harold65/SolarMeter/README.md

# SolarMeter
Documentation is stored in the 'docs' folder.

* Documentation on how to install the hardware is found in the (docs/hardwaremanual.pdf) file
* The software manual is found in docs/softwaremanual.pdf.
* An extra manual on setting up the libraries for this project can be found in [updating libraries](docs/Updating libraries for Solarmeter.pdf)
