harold65/SolarMeter/(threads)

Thread 1 (2017-04-29):

Temperature not logged correctly

harold65, 2017-04-29:
When using buienradar as source for temperature, the value is not correctly read.

FunnyAnimal, 2017-09-22:
I think this is related to the issue i just submitted, https://github.com/harold65/SolarMeter/issues/3 .

harold65, 2017-10-12:
The issue is not the value itself but the fact that the arduino is too slow to scan the >50K xml data returned from xml.buienradar.nl
Older Arduino versions have a faster (but less reliable) Find() function that will work ok.

FunnyAnimal, 2017-10-13:
What exactly do you mean with "Older Arduino versions" ? Older IDE?

I am using IDE version 1.8.3 and it works fine. (My Arduino UNO board is from May 2013.)

I use the following code in Temperature.cpp, it has been working fine now for over a year:

```
void Temperature::GetTemperature()
{
    // Get temperature from buienradar
    EthernetClient buienradarClient;

    int res = 0;
    int retries = 5;
    while (retries-- > 0 && res != 1)
    {
      res = buienradarClient.connect((char*)"xml.buienradar.nl",80);
      if (retries > 0 && res != 1) delay(561);  // Arbitrary delay
    }
    if(res == 1) // connection successfull
    {
        buienradarClient << F("GET / HTTP/1.1") << endl;
        buienradarClient << F("Host: xml.buienradar.nl") << endl << endl;

        retries = 50; // Wait maximally 50 * 0.05 = 2.5 seconds
        while(retries-- > 0
            && buienradarClient.connected()
            && ! buienradarClient.find((char*)weatherStation))
        {
            delay(50);
        } // while

        if (retries > 0)
        {
            if(buienradarClient.find((char*)"<temperatuurGC>"))
            {
                actual = buienradarClient.parseFloat();
                // Calculate new average
                average = (todayCnt * average) + actual;
                todayCnt++;
                average /= todayCnt;
            }
        }
        buienradarClient.stop();
    }
}
```

harold65, 2017-10-13:
please read this post and the following:
https://www.wijhebbenzon.nl/index.php/19-monitoren-loggen-en-meten/5410-solarmeter-v11-43?start=66#11255
Depending on hardware and ide version we get different results.

FunnyAnimal, 2017-10-13:
Yes, the retrieving can take quite long. But i don't care about that; for me it is important that it works and is reliable. The code I posted above works very reliable for me.

Closed 2017-10-12.

Thread 2 (2017-07-11):

No connection PVOutput due to network/DNS timeout/errors

LudoVicious, 2017-07-11:
At times, my Arduino can not connect to PVOutput. It reports "no connection" on the status page. I found out in the code that both the DNS request and PVOutput network connection are tried only once. If this fails this is interpreted as a PVOutput fail. Therefore I put the DNS request and PVOutput request statements in a loop to retry multiple times (>10) when the connection fails.
This makes the upload much more reliable in my case. Maybe a thought to be put in a code revision?

FunnyAnimal, 2017-09-22:
I agree. I replaced the code on line 92 of PVoutput.ino by:

```
int res = 0;
int retries = 5;
while (retries-- > 0 && res != 1)
{
  res = pvout.connect(ip_pvoutput,80);
  busy(0); // Strobe watchdog
}
```

DNS is less of an issue. The IP address is cached, so if dns.getHostByName fails the cached value is used, which is usually fine.

harold65, 2017-10-12:
Accepted. Will be implemented in 11.44

Closed 2017-10-12.

Thread 10 (2017-09-22):

Timeout too short, leading to spurious resets

FunnyAnimal, 2017-09-22:
https://github.com/harold65/SolarMeter/blob/8f2cf97f13b269b32c362e6a9be9c3d1aeaded7b/WatchDog.ino#L4

When using an Ethernet Shield based on W5500 hardware, a timeout of 1 minute is too little. With W5500 hardware (and possibly others), connect operations can take up to 31.8 seconds (see https://github.com/harold65/SolarMeter/issues/9 ) so then the 1 minute is easily reached. My proposal would be to set this timeout to 36000 (3 minutes).

Gertjezzz, 2020-03-27:
Did the setting of 3 minutes in timeout help you in recieving less resets?
After adding another S0 Meter (have 2 for usage and 1 for PV) I now recieve more resets.
Usually i have to reset the arduino several times after an software update to run it for months. But now I cant get it running a whole day without a reset.

Dylantje, 2020-03-27:
What arduino u use?
And what pins??

Perhaps take a look on my git i forked this solarmeter in to a simple version

Gertjezzz, 2020-03-28:
I use an Adruino uno with an ethernetshield (W5100). Had for, i believe, 1 a 2 years now 2 sensor setup. Yesterday I added an extra sensor and reconfigured the setup to:

- Pin 2: S0 Meter PV
- Pin 6: S0 Meter Consumption 1
- Pin 7: S0 Meter Consumption 2

I got the setup fully working but have some minor issues.

- Arduino gets stuck after some running time, so monitor and manually reset
- Missing the temperature readout (I tend to use PVoutput as less as possible, all my recordings are on exosite) I know the temp can bet fetched with a get of push message. If this isn't possible anymore with Buienradar I will look for another option, possibly adding an own sensor.

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

Thread 5 (2017-09-22):

Keep on trying to retrieve NTP time as long as the time is unknown

FunnyAnimal, 2017-09-22:
https://github.com/harold65/SolarMeter/blob/8f2cf97f13b269b32c362e6a9be9c3d1aeaded7b/Solarmeter.ino#L155

My suggestion would be to insert the following lines here:

        // Keep on trying to retrieve NTP time as long as we don't know the time.
        // In a situation of power line restore, the uplink (home router) might still be rebooting when the
        // call to UpdateTime() is made within setup() above.
        if (now() < 1451606400UL) UpdateTime(); // 1451606400UL is 2016-01-01 0:00:00

Thread 6 (2017-09-22):

upTime may be increased twice within the same hour

FunnyAnimal, 2017-09-22:
https://github.com/harold65/SolarMeter/blob/8f2cf97f13b269b32c362e6a9be9c3d1aeaded7b/Solarmeter.ino#L131

If UpdateTime() in line 140 sets the time backwards, upTime will be increased twice within the same hour.

Example: at 02:00, UpdateTime() is called, setting the time to 01:58 .
if(iHour != lastHour && iMinute == 0) --> lastHour = 2, iHour = 1 --> differs, but iMinute == 58 != 0
But two minutes later, lastHour = 1, iHour = 2 and iMinute == 0, so upTime is increased again.

FunnyAnimal, 2017-09-22:
Maybe it is a good idea to put lines 131...147 under a condition, like this:

```
        // Skip if last NTP update was recent.
        // Assuming updateTime() does not set back the time by more than 5 minutes.
        if (now() - lastNtpUpdate > 5 * SECS_PER_MIN)
        {
            upTime++;
            // save the daily values every hour
            for(byte i = 0; i < NUMSENSORS; i++)
            {
                sensors[i]->Save();
            }
            // Preferrably do time update only when no sun is shining. A time shift can distort the
            // "average" output of pvoutput: if the current period becomes (let's say) 12 minutes instead
            // of 10 due to a 2 minute clock backwards setting, the average may be above the peak value,
            // that is very ugly.
            if (lastHour == 2)
            {
                UpdateTime();
            }
            #ifdef USE_MAIL
                if(lastHour == MAIL_TIME)
                {
                    SendMail();
                }
            #endif
        }
    }

```

Thread 11 (2017-12-20):

Buienradar switched to https

FunnyAnimal, 2017-12-20:
https://github.com/harold65/SolarMeter/blob/8f2cf97f13b269b32c362e6a9be9c3d1aeaded7b/Temperature.cpp#L44

A few days ago, buienradar switched to https in their serving of xml.buienradar.nl . So this code no longer works...

Gertjezzz, 2020-03-27:
Anyone got the code for retrieving temperature working again?

Dylantje, 2020-03-27:
Harold is not support this any more...
Remove buienradar and use in pv output the temp option [ free ]

Thread 13 (2019-06-12):

Gas identifier 0-1:24.2.1

Koepel, 2019-06-12:
On the Dutch arduinoforum.nl there is [a thread with a other idientifier](http://arduinoforum.nl/viewtopic.php?f=8&t=3535) for the gas.
The code is now for:
```
0-1:24.3.0(16100733220000)(00)(60)(1)(0-1:24.2.1)(m3)
(04650.798)
```
But the other one is:
```
0-1:24.2.1(181106140010W)(01569.646*m3)
```
I have choosen not to combine them, because they are so different.
I would like to replace this:
```
    // gas definition: 0-1:24.3.0
    if (sscanf(buffer,"0-1:24.%d.%d",&i,&j) == 2)
    {
	  if(i == 3 && j == 0) readnextLine = true; // the actual gas counter is found on the next line
    }
```
with this:
```
    // gas definition: 0-1:24.3.0    gas value will be on the next line
    //                 0-1:24.2.1    normal gas definition
    //
    // The timeText will be 14 characters (13 + zero terminator).
    // It has the format:
    //   YYMMDDhhmmssX
    //     Year, Month, Day, Hour, Minute, Second,
    //     and 'S' for DST active or 'W' for DST is not active.
    // It can be retrieved with sscanf with %13s or %13c.
    // The %13s will reads up to 13 characters, stops at space or tab.
    // The %13c will read exactly 13 characters.
    // With %13c a zero terminator has to be added:
    //   timeText[13] = '\0';
    // Reference: http://www.cplusplus.com/reference/cstdio/scanf/
    char timeText[16];

    // The "0-1:24.3.0" is a special case for the gas.
    // There is a "0-1:24.2.1" at the end of that line,
    // but the actual gas value will be on the next line.
    const char gasID2430[] = "0-1:24.3.0";

    if( strncmp( buffer, gasID2430, strlen( gasID2430)) == 0)
    {
      readnextLine = true;
    }
    else if( sscanf(buffer, "0-1:24.2.1(%13s)(%ld.%ld*m3)", timeText, &tl, &tld) == 3)
    {
      GasUsage = (tl * 1000) + tld;
    }
```
Only tested in a simulation.

Koepel, 2019-06-12:
It [has been confirmed](http://arduinoforum.nl/viewtopic.php?f=8&t=3535&start=10#p25384) that the "0-1:24.2.1" works. I assume that the "0-1:24.3.0" also still works.

harold65, 2019-06-15:
Thank you for the update.
