harold65/SolarMeter/FlashMini.h

/*
  Flash.h - An Arduino library for flash-based (ROM) data collections.
  Copyright (C) 2009 Mikal Hart
  All rights reserved.

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
  You should have received a copy of the GNU Lesser General Public
  License along with this library; if not, write to the Free Software
  Foundation, Inc., 51 Franklin St, Fifth Floor, Boston, MA  02110-1301  USA
*/
#ifndef Flash_h
#define Flash_h

#include <avr/pgmspace.h>
#include <Arduino.h>

#define FLASH_LIBRARY_VERSION 4

#ifndef ARDUINO_STREAMING
#define ARDUINO_STREAMING

template<class T> 
inline Print &operator <<(Print &stream, T arg) 
{ stream.print(arg); return stream; }

enum _EndLineCode { endl };

inline Print &operator <<(Print &stream, _EndLineCode arg) 
{ stream.println(); return stream; }

#endif

#endif
