harold65/SolarMeter/(commit log)

2012-10-21 First version for Arduino 1.0
2012-10-21 - Improved stability by removing time functions from interrupt. - Removed pvtotal since pvoutput can do this now. - Removed standard libraries as they are already present in Arduino ide
    [PVoutput.ino, Solarmeter.ino, Time.ino]
2012-10-21 Changed S0 sensor so that it can handle any amount of pulses per kWh Had to remove the Total counter because memory is full.
2012-11-13 Made the code more flexible (but worse to read) You can now define 3 sensors, their input pins, their resolution and the direction (consumption or production) all via userdefs.h Also the logging to S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
2012-11-18 Fixed 2 typo's causing the consumption upload not working Added mail client
    [Mail.ino, PVoutput.ino, Solarmeter.ino]
2012-11-20 V8.2: fixed hangup in waiting for pvoutput response
    [PVoutput.ino, Solarmeter.ino, WebStuff.ino]
2012-12-01 Changed time server from static IP to DNS name. This will prevent a hangup if ipaddress of time server changes.
    [Solarmeter.ino, Time.ino]
2012-12-28 V8.5: Better upload to PVoutput by toleration DNS errors.
    [PVoutput.ino, Solarmeter.ino]
2012-12-28 V9: Added AnalogSensor, FerrarisSensor and Temperature sensor Can also calculate graaddagen
2013-01-05 V9.1: Fixed bug in calculating negative values from ferraris Do not overwrite the existing temperature data on PvOutput if temperature sensor is not used fix for linux users
    [BaseSensor.cpp, PVoutput.ino, Solarmeter.ino]
2013-02-13 V11: Exosite upload at 1 minute, log first line of site responses for clear error message
    [AnalogSensor.cpp, BaseSensor.h, Exosite.ino, FerrarisSensor.cpp, MinderGas.ino, P1Power.h, PVoutput.ino, Solarmeter.ino]
2013-02-24 V11.1: Improved counter reset, store mindergas response time, upload mindergas at random time between 0:00 and 1:00
    [MinderGas.ino, Solarmeter.ino, Time.ino, WebStuff.ino]
2013-03-31 Prevent negative consumption to pvoutput
    [BaseSensor.cpp, Exosite.ino, PVoutput.ino, Solarmeter.ino, WatchDog.ino, WebStuff.ino]
2013-07-25 fixed bug in consumption calculation
    [PVoutput.ino]
2013-07-25 fixed exosite response logging
    [Exosite.ino]
2013-08-25 Fixed mindergas response and improved 'new hour' checking to prevent double mail
    [MinderGas.ino, Solarmeter.ino, Time.ino, WebStuff.ino, userdefs_org.h]
2013-12-24 Fixed some minor issues
    [Solarmeter.ino, Time.ino, WebStuff.ino, userdefs_org.h]
2014-01-03 Fixed bug in newhour (and newminute) checking.
    [Solarmeter.ino]
2014-05-11 Fixed: P1 sensor total's. Changed pvoutput response to text.
    [P1GasSensor.cpp, P1Power.cpp, PVoutput.ino, Solarmeter.ino]
2014-05-29 Allow SID >32767; show correct pvoutput error messages; added /restart
    [BaseSensor.cpp, BaseSensor.h, PVoutput.ino, Solarmeter.ino, WebStuff.ino, userdefs_org.h]
2016-03-28 Update DST, fixed libraries
    [BaseSensor.h, Exosite.ino, FlashMini.h, Mail.ino, MinderGas.ino, PVoutput.ino, Solarmeter.ino, Temperature.cpp]
2017-04-29 Fixed exosite
    Array size was too small
    [Exosite.ino]
2017-04-29 Arduino ide update
    Changes due to ide update
